freakyengine/GPIBoE-Gateway/hardware/raspberry_gpib_extention.pdf

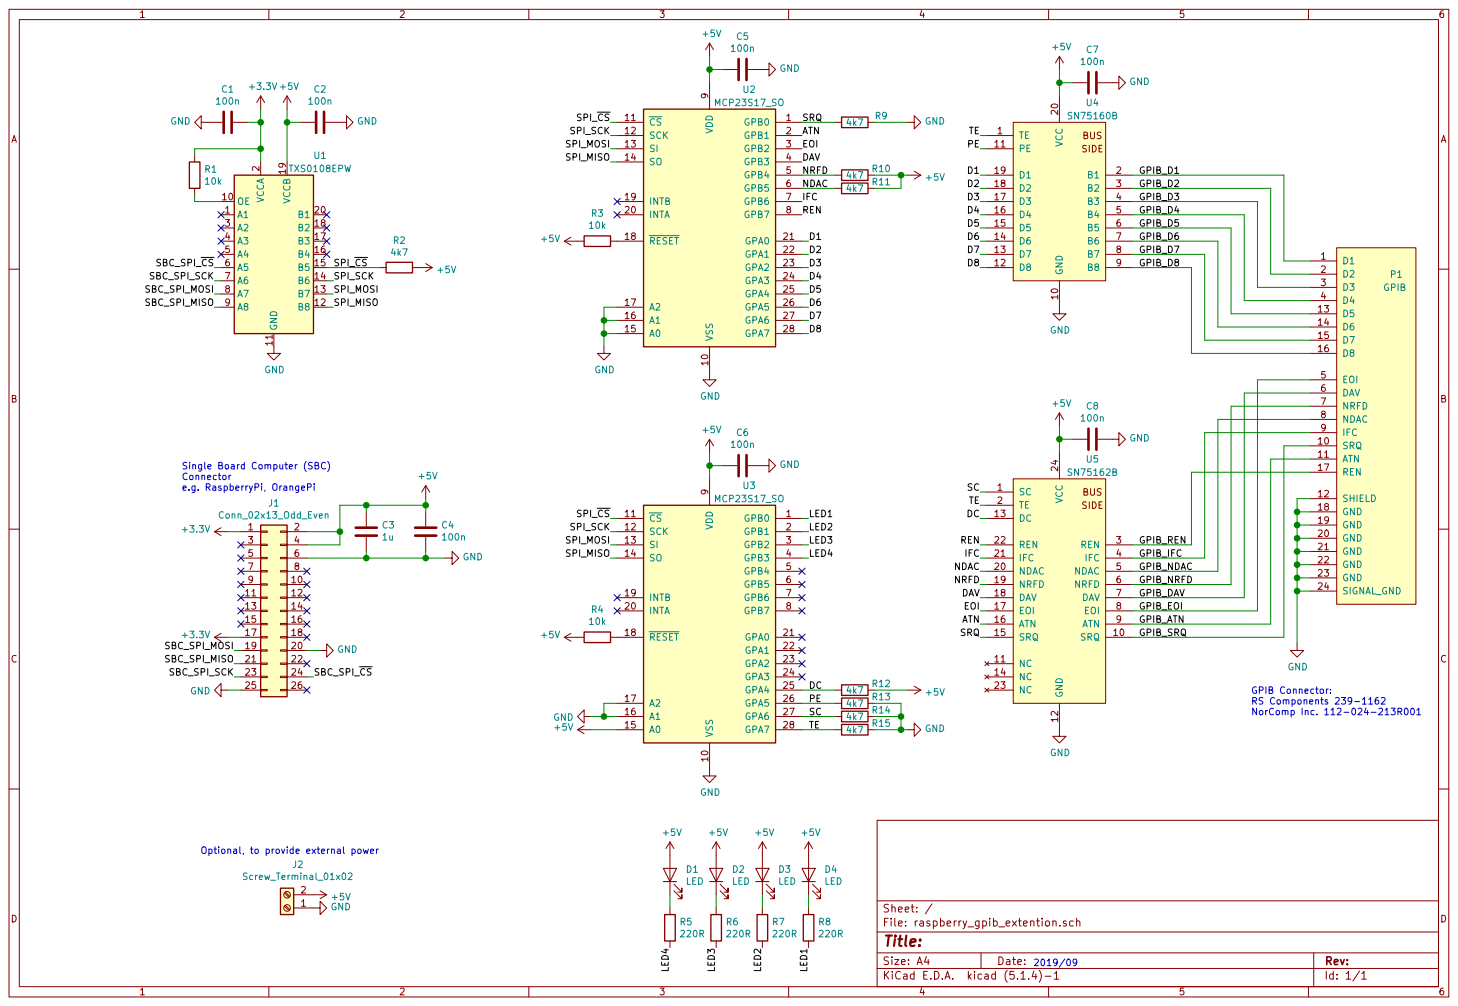
[picture p1: page 1]
