freakyengine/GPIBoE-Gateway/hardware/raspberry_gpib_extention.sch

## KiCad design hardware/raspberry_gpib_extention.sch (2019-09-09)

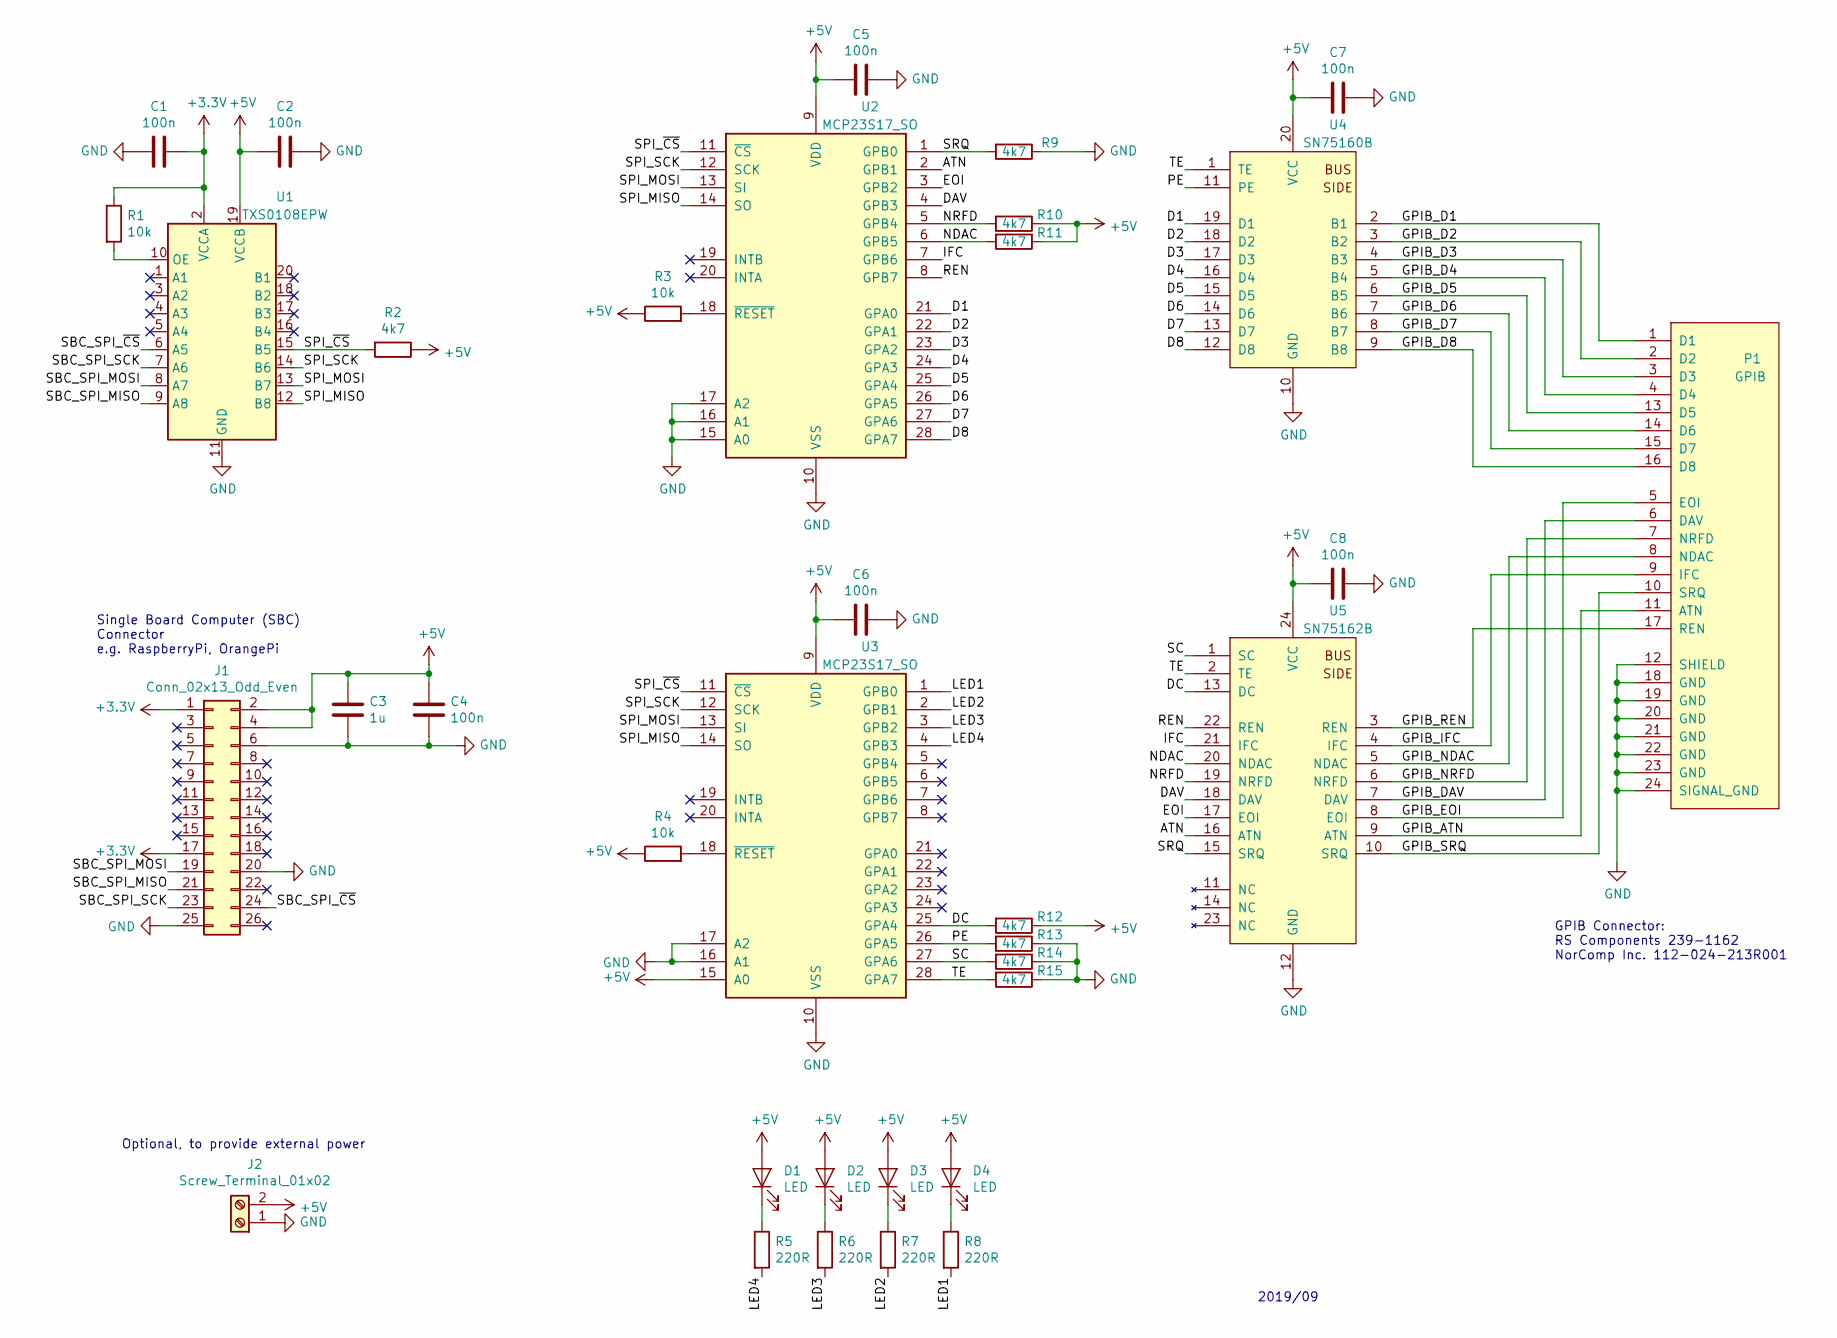
[picture p2: schematic raspberry_gpib_extention.sch]

Parts:
C1, C2, C4, C5, C6, C7, C8: 100n
C3: 1u
D1, D2, D3, D4: LED
J1: Conn_02x13_Odd_Even
J2: Screw_Terminal_01x02
P1: GPIB
R1, R3, R4: 10k
R2, R9, R10, R11, R12, R13, R14, R15: 4k7
R5, R6, R7, R8: 220R
U1: TXS0108EPW; TSSOP-20_4.4x6.5mm_P0.65mm
U2, U3: MCP23S17_SO; SOIC-28W_7.5x17.9mm_P1.27mm
U4: SN75160B; SOIC-20W_7.5x12.8mm_P1.27mm
U5: SN75162B; SOIC-24W_7.5x15.4mm_P1.27mm

Connections:
+3.3V: C1.2, J1.1, J1.17, R1.1, U1.2 (VCCA)
+5V: C2.2, C3.2, C4.2, C5.2, C6.2, C7.2, C8.2, D1.2 (A), D2.2 (A), D3.2 (A), D4.2 (A), J1.2, J1.4, J2.2, R2.1, R3.1, R4.1, R10.1, R11.1, R12.1, U1.19 (VCCB), U2.9 (VDD), U3.9 (VDD), U3.15 (A0), U4.20 (VCC), U5.24 (VCC)
ATN: U2.2 (GPB1), U5.16 (ATN)
D1: U2.21 (GPA0), U4.19 (D1)
D2: U2.22 (GPA1), U4.18 (D2)
D3: U2.23 (GPA2), U4.17 (D3)
D4: U2.24 (GPA3), U4.16 (D4)
D5: U2.25 (GPA4), U4.15 (D5)
D6: U2.26 (GPA5), U4.14 (D6)
D7: U2.27 (GPA6), U4.13 (D7)
D8: U2.28 (GPA7), U4.12 (D8)
DAV: U2.4 (GPB3), U5.18 (DAV)
DC: R12.2, U3.25 (GPA4), U5.13 (DC)
EOI: U2.3 (GPB2), U5.17 (EOI)
GND: C1.1, C2.1, C3.1, C4.1, C5.1, C6.1, C7.1, C8.1, J1.6, J1.20, J1.25, J2.1, P1.12 (SHIELD), P1.18 (GND), P1.19 (GND), P1.20 (GND), P1.21 (GND), P1.22 (GND), P1.23 (GND), P1.24 (SIGNAL_GND), R9.1, R13.1, R14.1, R15.1, U1.11 (GND), U2.10 (VSS), U2.15 (A0), U2.16 (A1), U2.17 (A2), U3.10 (VSS), U3.16 (A1), U3.17 (A2), U4.10 (GND), U5.12 (GND)
GPIB_ATN: P1.11 (ATN), U5.9 (ATN)
GPIB_D1: P1.1 (D1), U4.2 (B1)
GPIB_D2: P1.2 (D2), U4.3 (B2)
GPIB_D3: P1.3 (D3), U4.4 (B3)
GPIB_D4: P1.4 (D4), U4.5 (B4)
GPIB_D5: P1.13 (D5), U4.6 (B5)
GPIB_D6: P1.14 (D6), U4.7 (B6)
GPIB_D7: P1.15 (D7), U4.8 (B7)
GPIB_D8: P1.16 (D8), U4.9 (B8)
GPIB_DAV: P1.6 (DAV), U5.7 (DAV)
GPIB_EOI: P1.5 (EOI), U5.8 (EOI)
GPIB_IFC: P1.9 (IFC), U5.4 (IFC)
GPIB_NDAC: P1.8 (NDAC), U5.5 (NDAC)
GPIB_NRFD: P1.7 (NRFD), U5.6 (NRFD)
GPIB_REN: P1.17 (REN), U5.3 (REN)
GPIB_SRQ: P1.10 (SRQ), U5.10 (SRQ)
IFC: U2.7 (GPB6), U5.21 (IFC)
LED1: R8.2, U3.1 (GPB0)
LED2: R7.2, U3.2 (GPB1)
LED3: R6.2, U3.3 (GPB2)
LED4: R5.2, U3.4 (GPB3)
NDAC: R11.2, U2.6 (GPB5), U5.20 (NDAC)
NRFD: R10.2, U2.5 (GPB4), U5.19 (NRFD)
unnamed: D1.1 (K), R5.1
unnamed: D2.1 (K), R6.1
unnamed: D3.1 (K), R7.1
unnamed: D4.1 (K), R8.1
unnamed: R1.2, U1.10 (OE)
unnamed: R3.2, U2.18 (~RESET~)
unnamed: R4.2, U3.18 (~RESET~)
PE: R13.2, U3.26 (GPA5), U4.11 (PE)
REN: U2.8 (GPB7), U5.22 (REN)
SBC_SPI_MISO: J1.21, U1.9 (A8)
SBC_SPI_MOSI: J1.19, U1.8 (A7)
SBC_SPI_SCK: J1.23, U1.7 (A6)
SBC_SPI_~CS~: J1.24, U1.6 (A5)
SC: R14.2, U3.27 (GPA6), U5.1 (SC)
SPI_MISO: U1.12 (B8), U2.14 (SO), U3.14 (SO)
SPI_MOSI: U1.13 (B7), U2.13 (SI), U3.13 (SI)
SPI_SCK: U1.14 (B6), U2.12 (SCK), U3.12 (SCK)
SPI_~CS~: R2.2, U1.15 (B5), U2.11 (~CS~), U3.11 (~CS~)
SRQ: R9.2, U2.1 (GPB0), U5.15 (SRQ)
TE: R15.2, U3.28 (GPA7), U4.1 (TE), U5.2 (TE)

Notes on the sheet:
GPIB Connector: RS Components 239-1162 NorComp Inc. 112-024-213R001
Single Board Computer (SBC) Connector e.g. RaspberryPi, OrangePi
Optional, to provide external power
2019/09
